volaser/volaser-cad/README.md

# volaser-cad
CAD files and assembly instructions to create your very own volaser

## Assembly
Assembly instructions are detailed step by step in the [wiki](https://github.com/volaser/volaser-cad/wiki)
