volaser/volaser-cad/images/capacitor.jpg

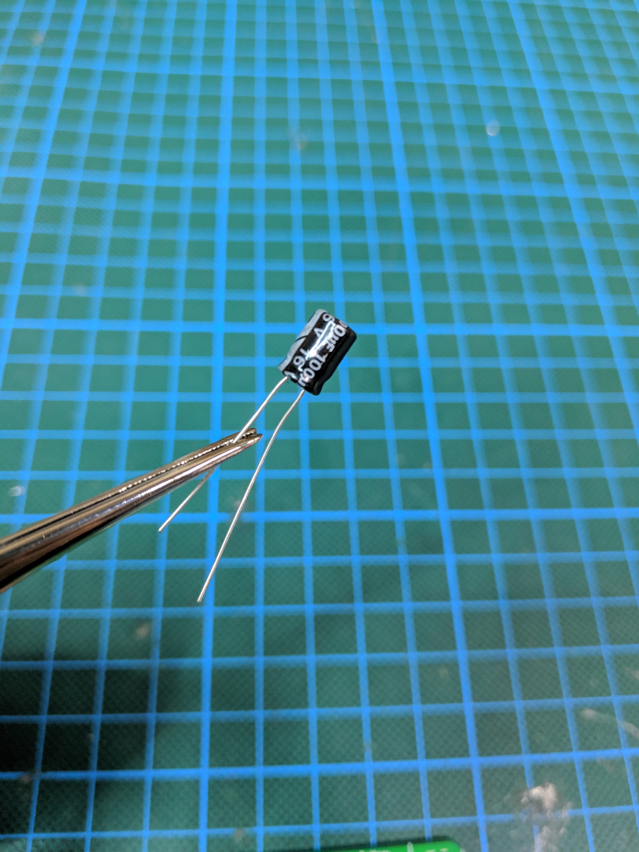
images/capacitor.jpg
