volaser/volaser-cad/images/volaser_motor_driver.jpg

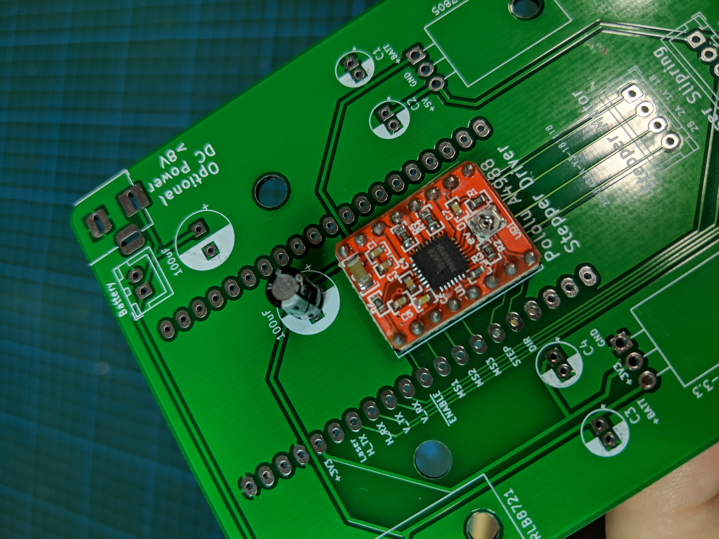
images/volaser_motor_driver.jpg
