volaser/volaser-cad/images/volaser_pcb.jpg

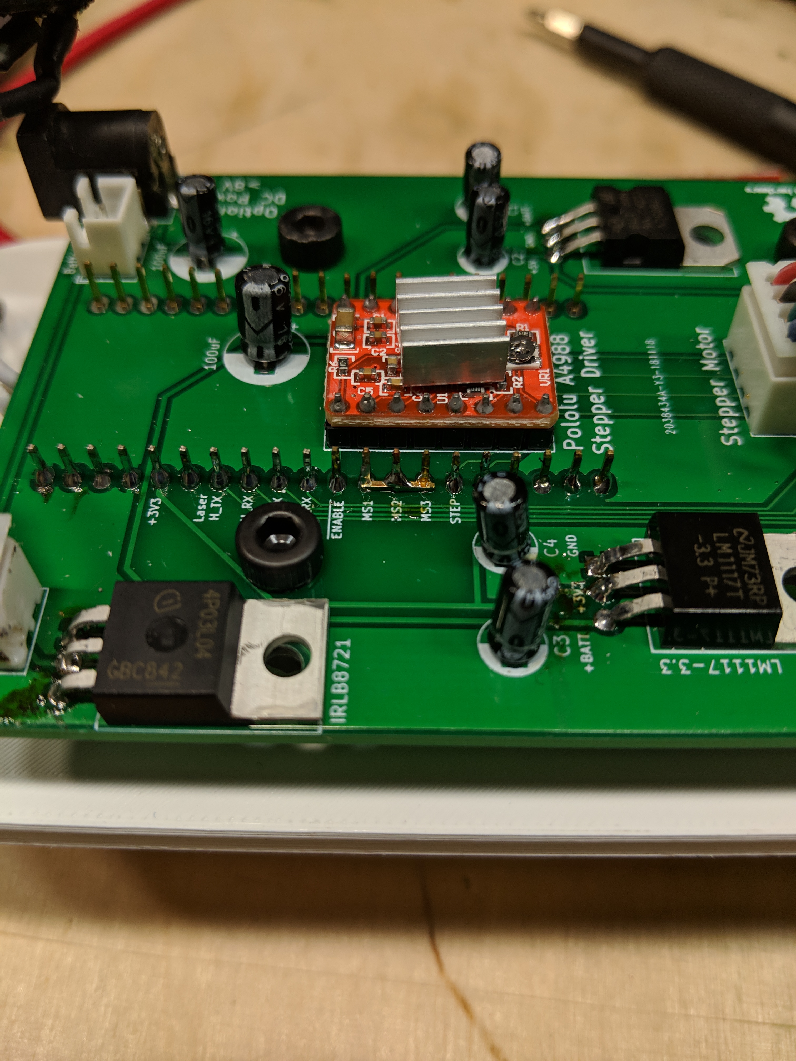
images/volaser_pcb.jpg
