volaser/volaser-cad/images/volaser_stepper.jpg

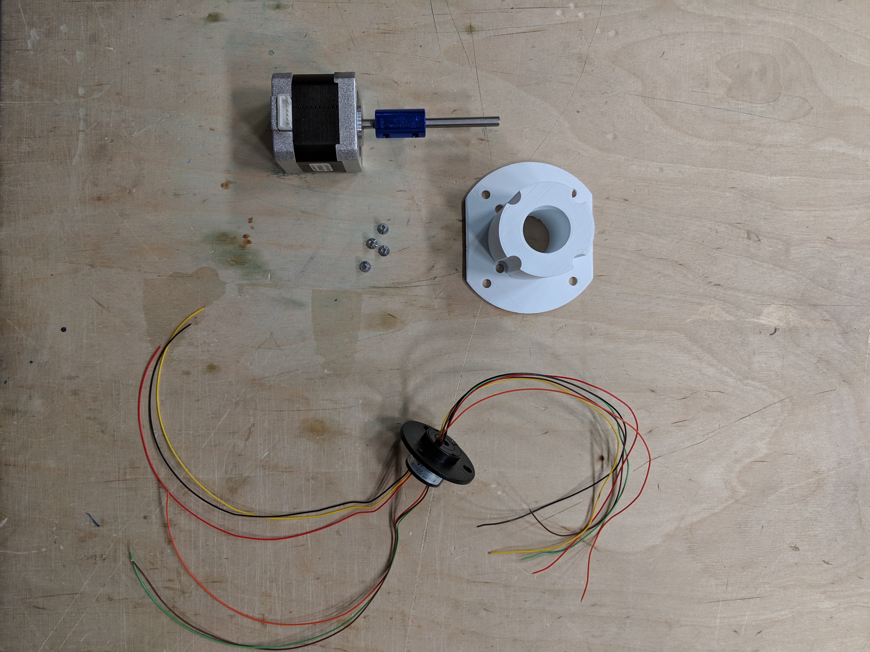
images/volaser_stepper.jpg
