volaser/volaser-cad/images/volaser_voltage_regulator.jpg

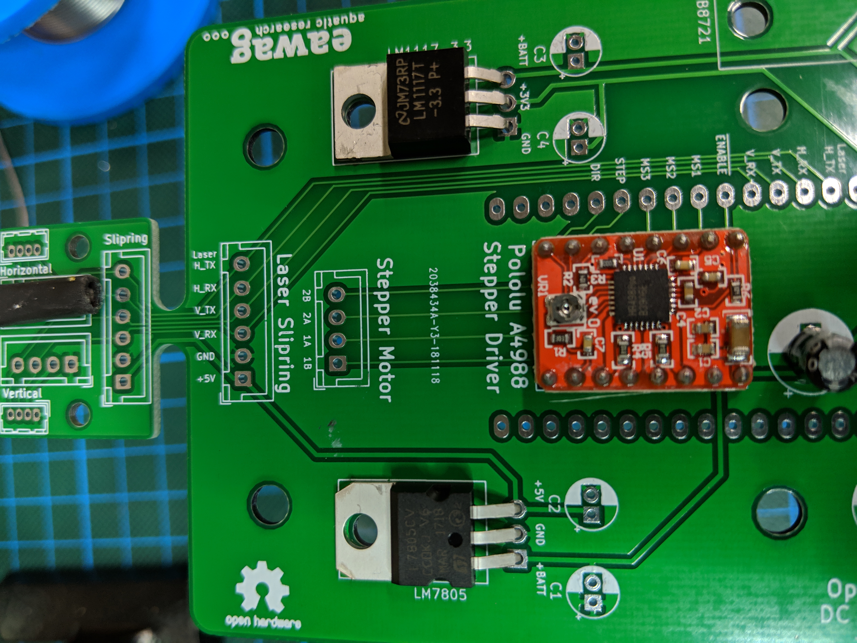
images/volaser_voltage_regulator.jpg
