volaser/volaser-cad/images/winch_capacitors.jpg

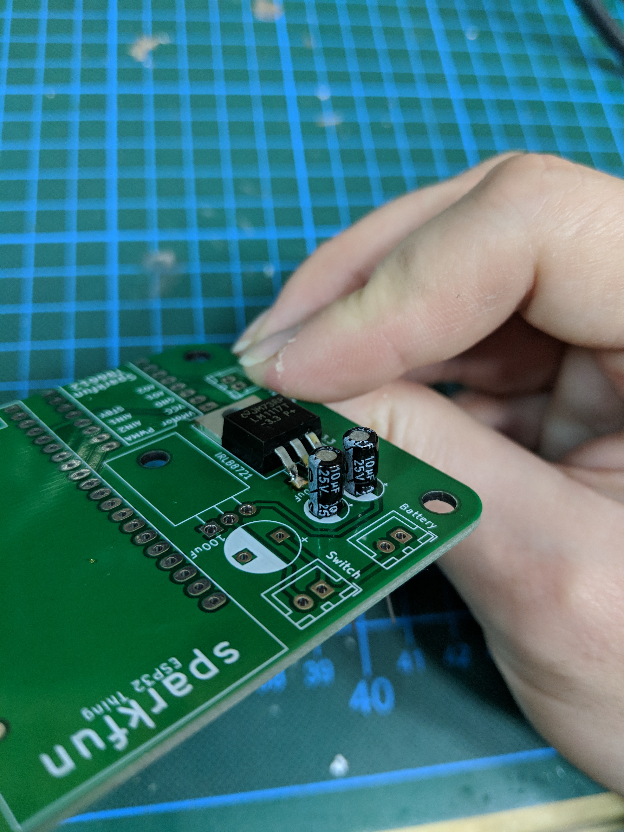
images/winch_capacitors.jpg
