volaser/volaser-cad/images/winch_connectors.jpg

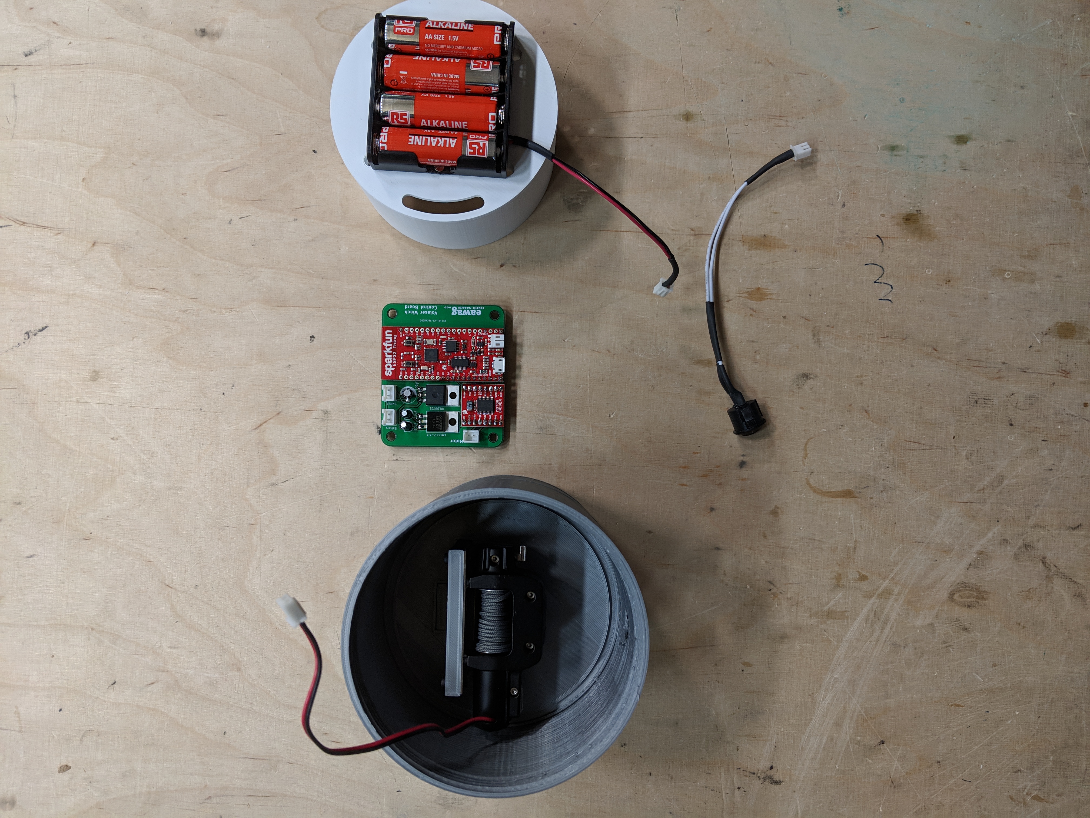
images/winch_connectors.jpg
