volaser/volaser-cad/images/winch_pcb_mounted.jpg

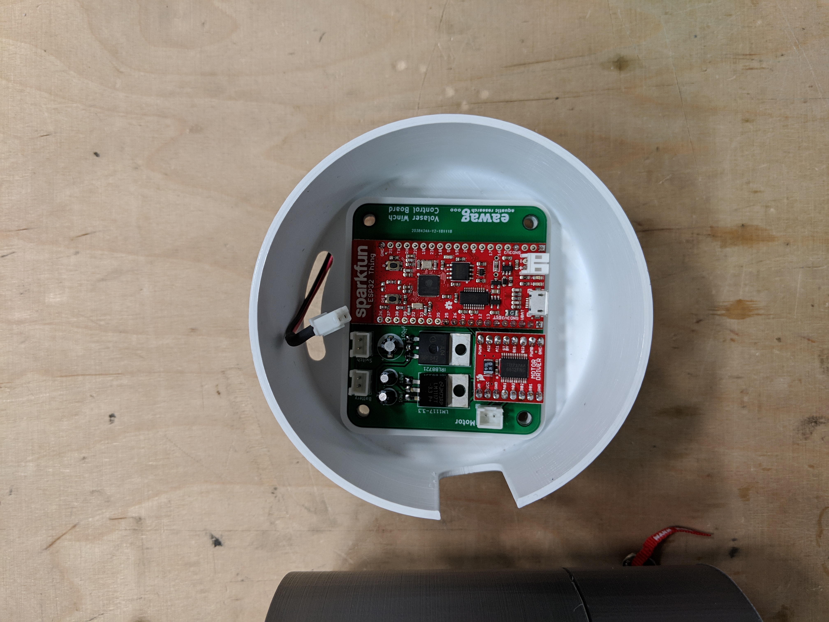
images/winch_pcb_mounted.jpg
