volaser/volaser-cad/winch-pcb/images/volaser_winch2.png

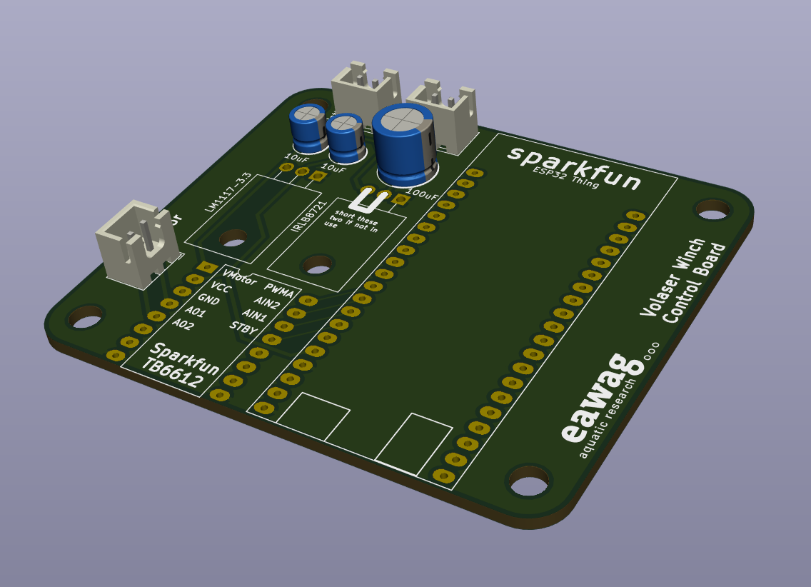
winch-pcb/images/volaser_winch2.png
