volaser/volaser-cad/volaser-parts/housing_cap.stl

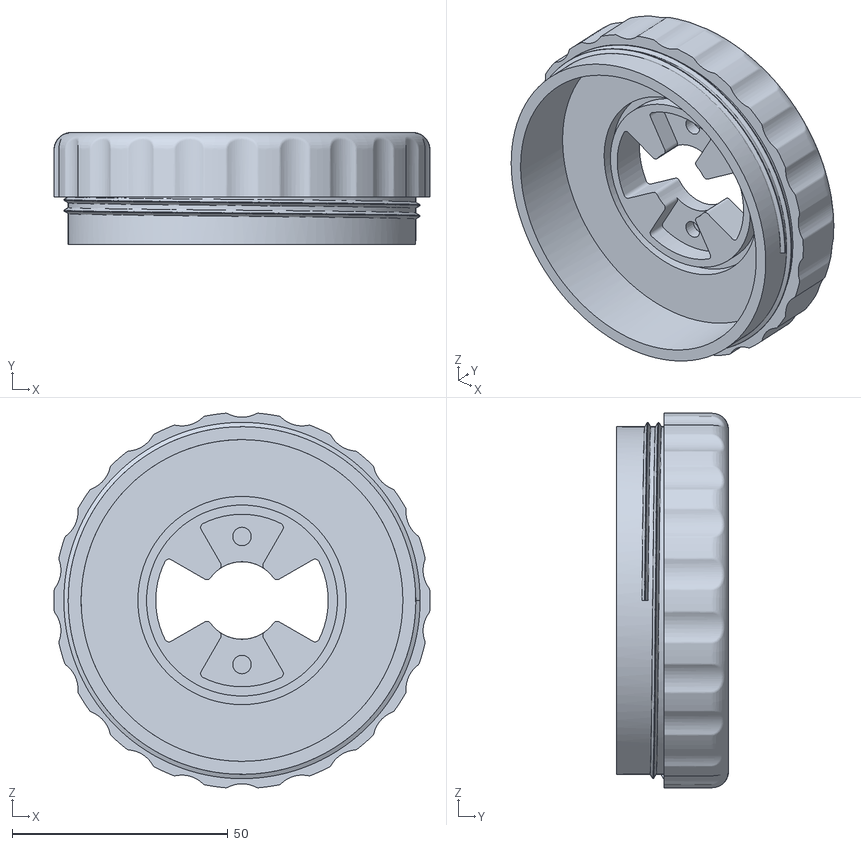
[picture p12: CAD file, 2019-01-12]
volaser-parts/housing_cap.stl
87.2 x 26.0 x 86.9
