volaser/volaser-cad/volaser-pcb/volaser.step

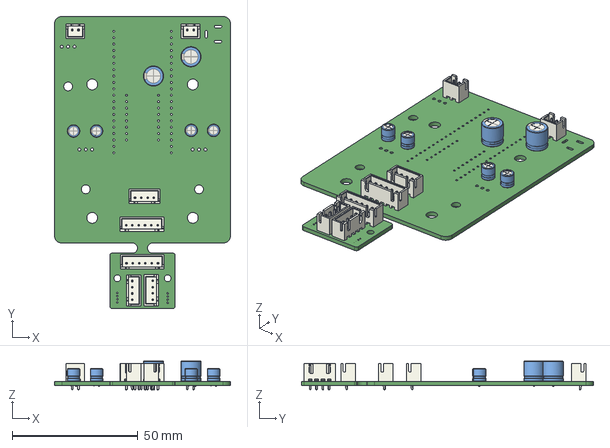
[picture p13: CAD file, 2019-01-12]
volaser-pcb/volaser.step
70.0 x 116.0 x 11.4 mm
