volaser/volaser-cad/winch-parts/winch_motor_mount.stl

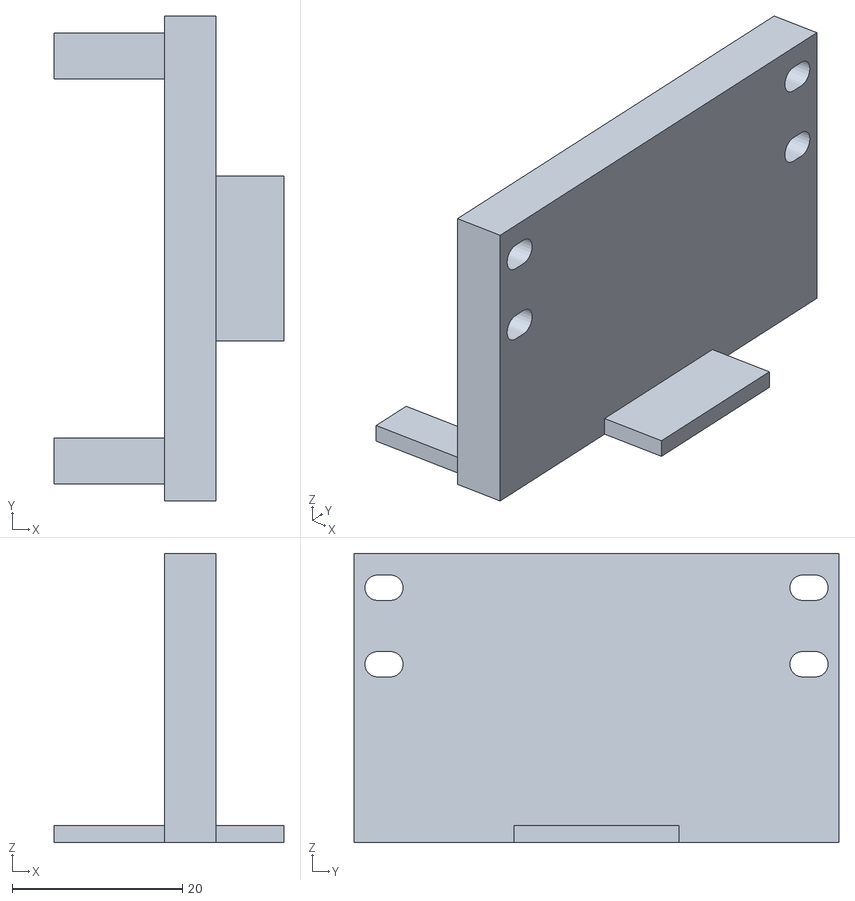
[picture p14: CAD file, 2019-01-12]
winch-parts/winch_motor_mount.stl
27.0 x 57.0 x 34.0
