volaser/volaser-cad/winch-pcb/winch.step

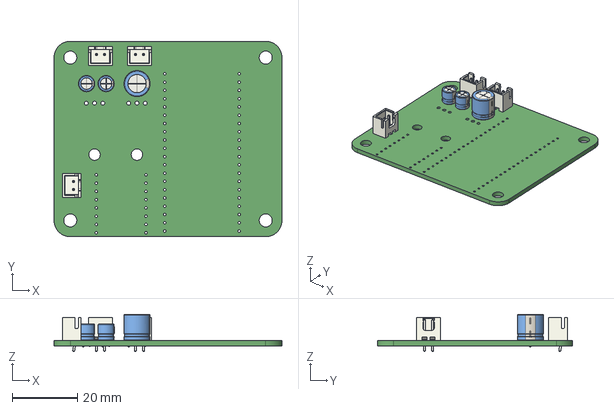
[picture p15: CAD file, 2019-01-12]
winch-pcb/winch.step
70.0 x 60.0 x 11.4 mm
