volaser/volaser-cad/volaser-parts/cap.stl

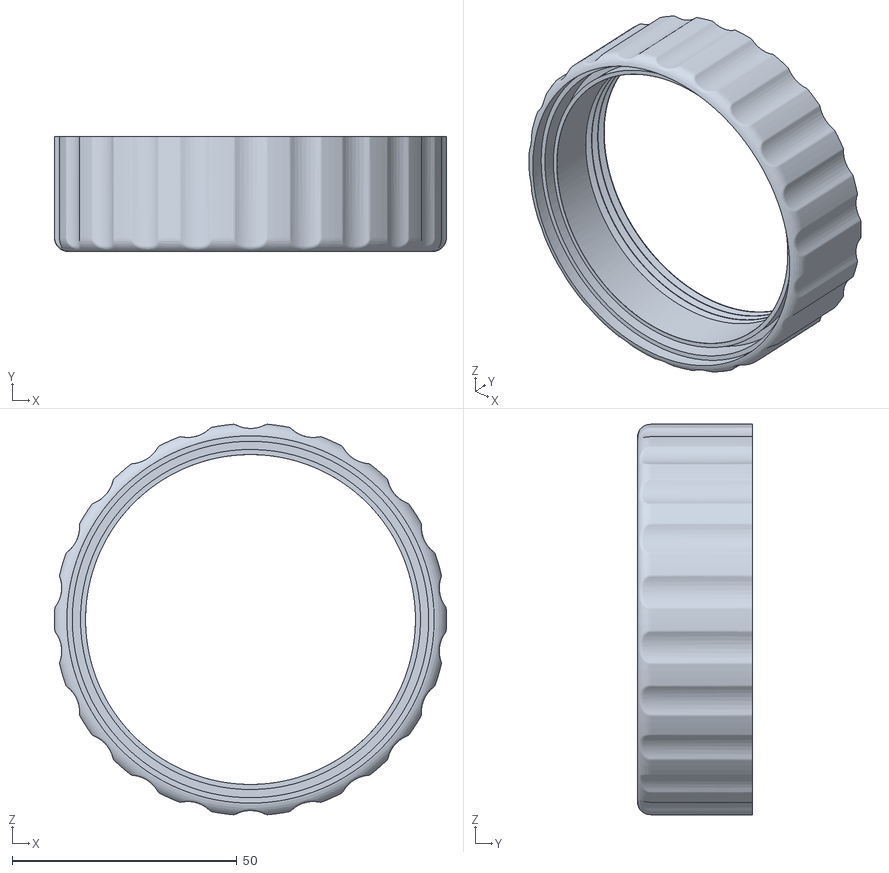
[picture p16: CAD file, 2019-01-12]
volaser-parts/cap.stl
87.2 x 25.5 x 86.9
