volaser/volaser-cad/winch-parts/winch_cap.stl

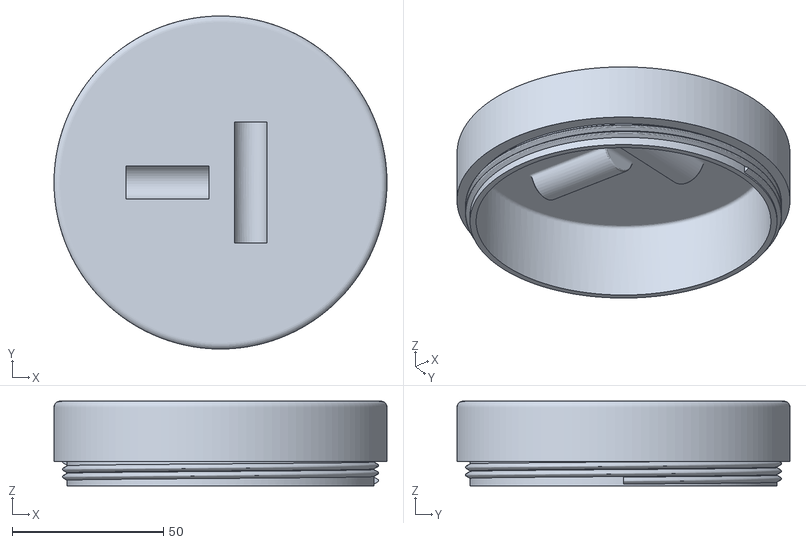
[picture p17: CAD file, 2019-01-12]
winch-parts/winch_cap.stl
110.0 x 110.0 x 28.0
