volaser/volaser-cad/volaser-parts/laser_holder.stl

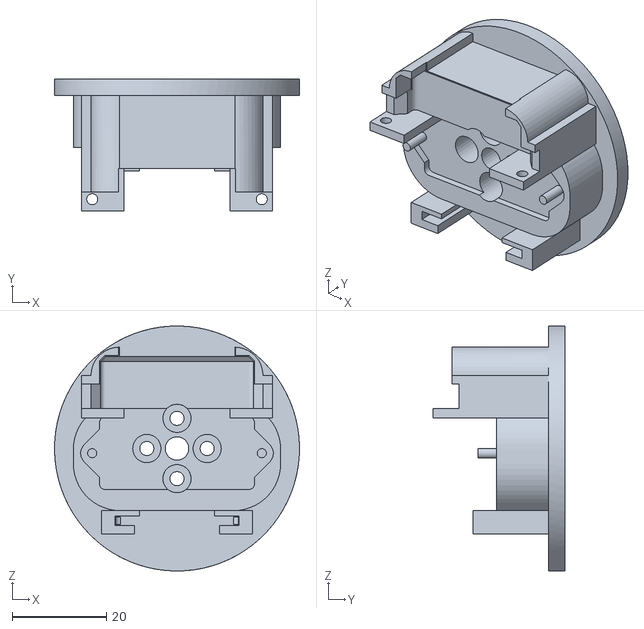
[picture p18: CAD file, 2019-01-12]
volaser-parts/laser_holder.stl
52.0 x 28.0 x 52.0
