volaser/volaser-cad/winch-parts/level_cover1.stl

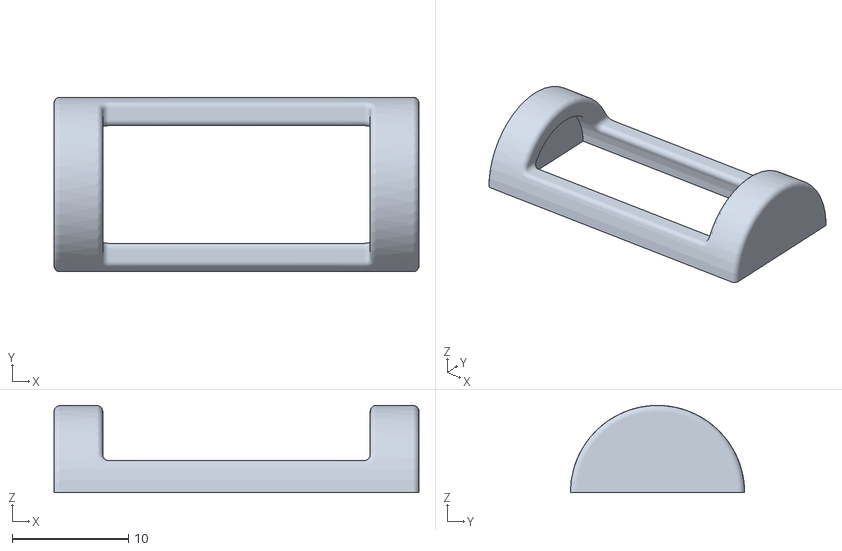
[picture p19: CAD file, 2019-01-12]
winch-parts/level_cover1.stl
31.4 x 15.0 x 7.50
