volaser/volaser-cad/volaser-parts/spine.stl

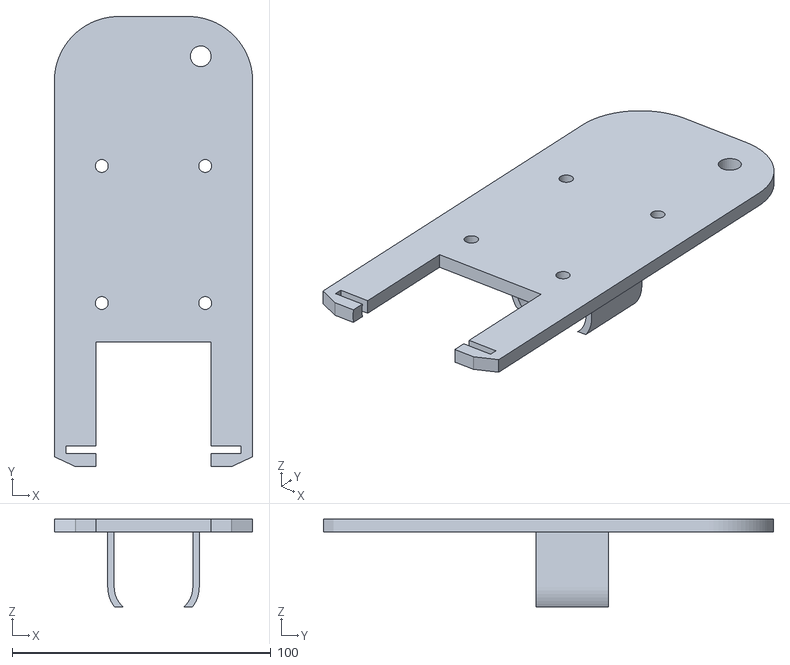
[picture p20: CAD file, 2019-01-12]
volaser-parts/spine.stl
76.7 x 174.0 x 34.0
