volaser/volaser-cad/winch-parts/winch_lower_housing.stl

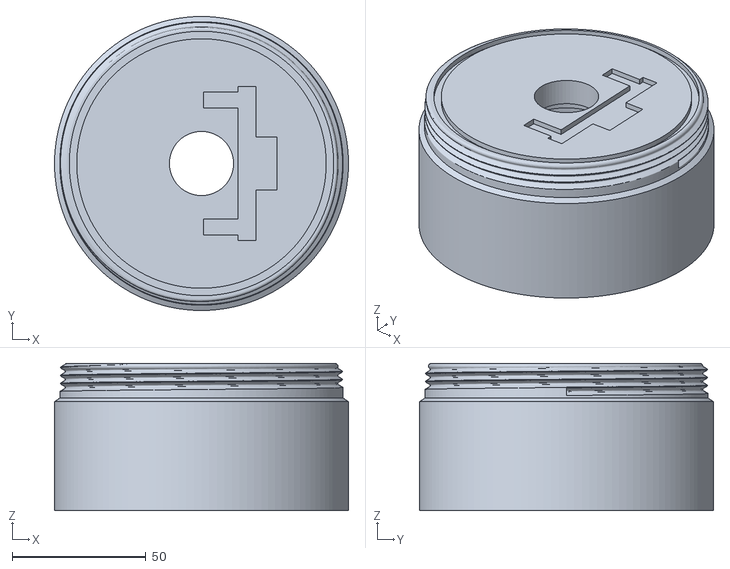
[picture p21: CAD file, 2019-01-12]
winch-parts/winch_lower_housing.stl
110.0 x 110.0 x 55.0
