volaser/volaser-cad/volaser-parts/winch_hook.stl

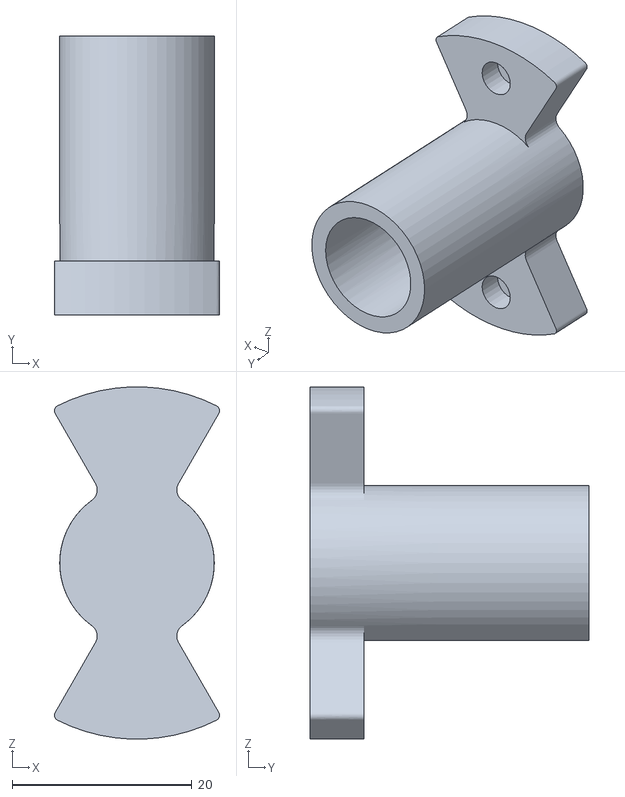
[picture p22: CAD file, 2019-01-12]
volaser-parts/winch_hook.stl
18.4 x 31.0 x 39.2
