volaser/volaser-cad/winch-parts/level_cover2.stl

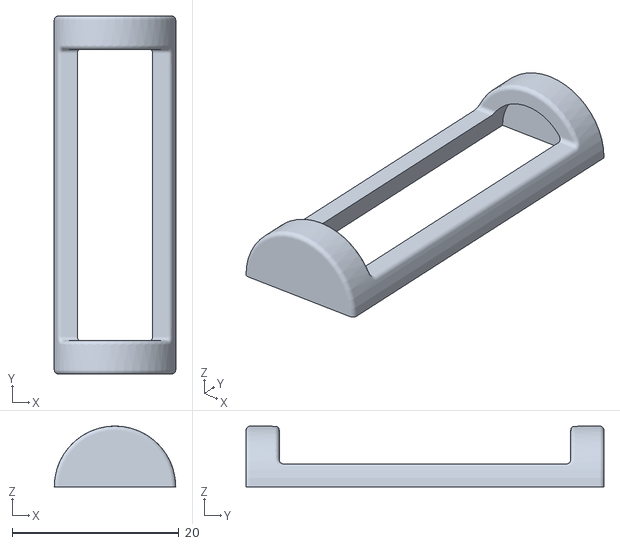
[picture p23: CAD file, 2019-01-12]
winch-parts/level_cover2.stl
14.6 x 43.0 x 7.30
