volaser/volaser-cad/volaser-parts/lower_housing.stl

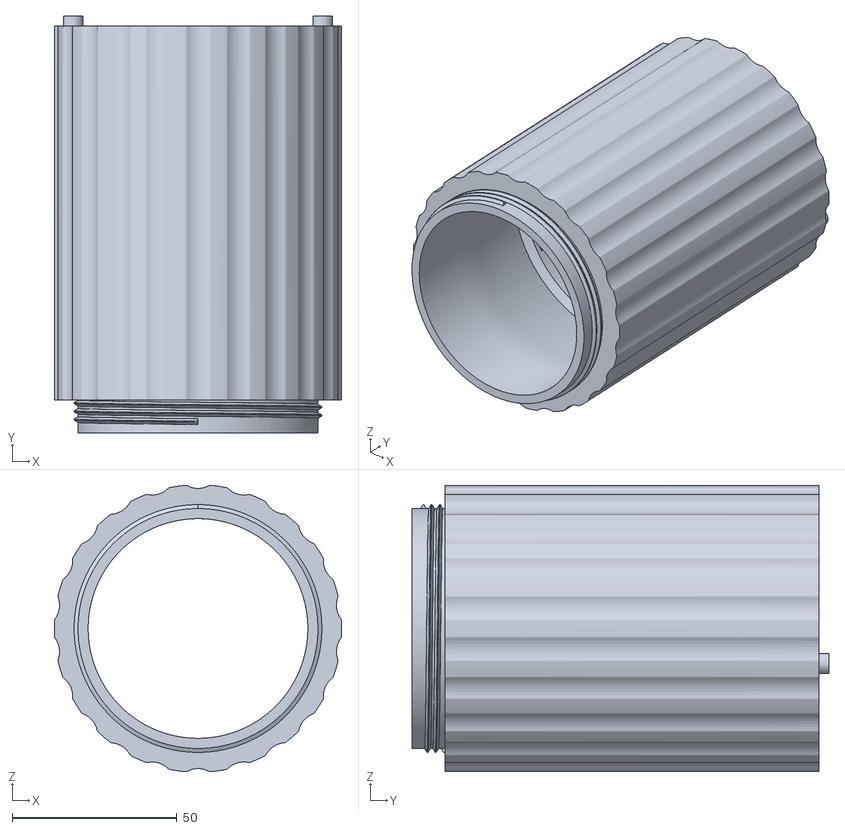
[picture p24: CAD file, 2019-01-12]
volaser-parts/lower_housing.stl
87.2 x 126.5 x 86.9
