volaser/volaser-cad/winch-parts/winch.step

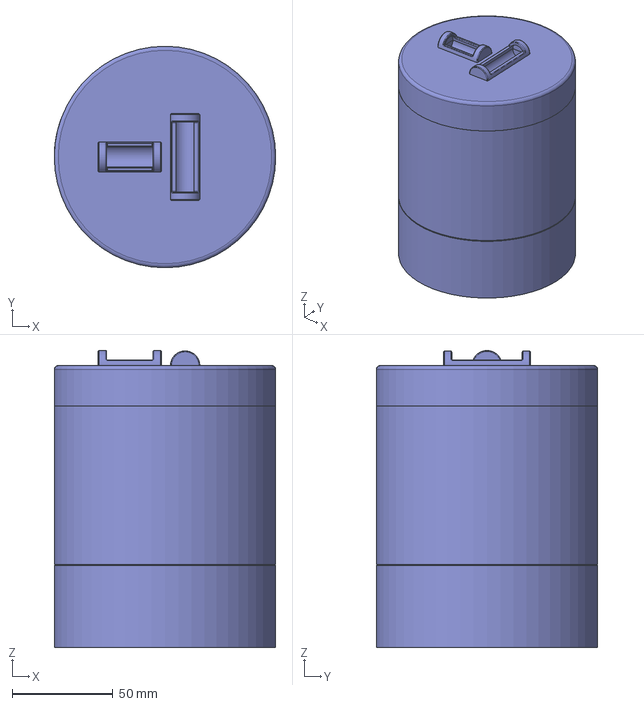
[picture p25: CAD file, 2019-01-12]
winch-parts/winch.step
110.0 x 110.0 x 147.5 mm
