volaser/volaser-cad/volaser-parts/upper_housing.stl

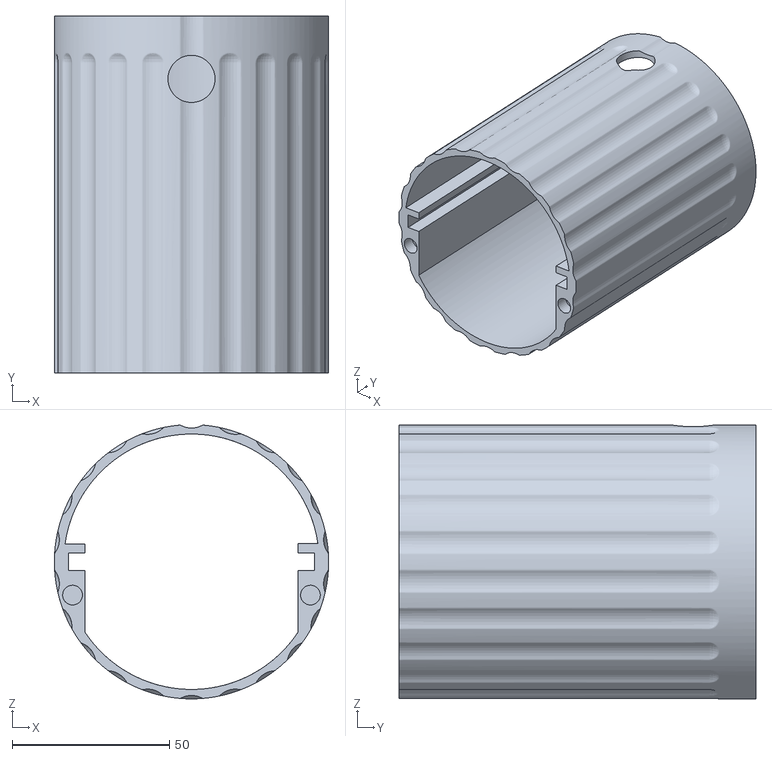
[picture p26: CAD file, 2019-01-12]
volaser-parts/upper_housing.stl
87.2 x 113.5 x 87.0
