volaser/volaser-cad/winch-parts/winch_pcb_mount.stl

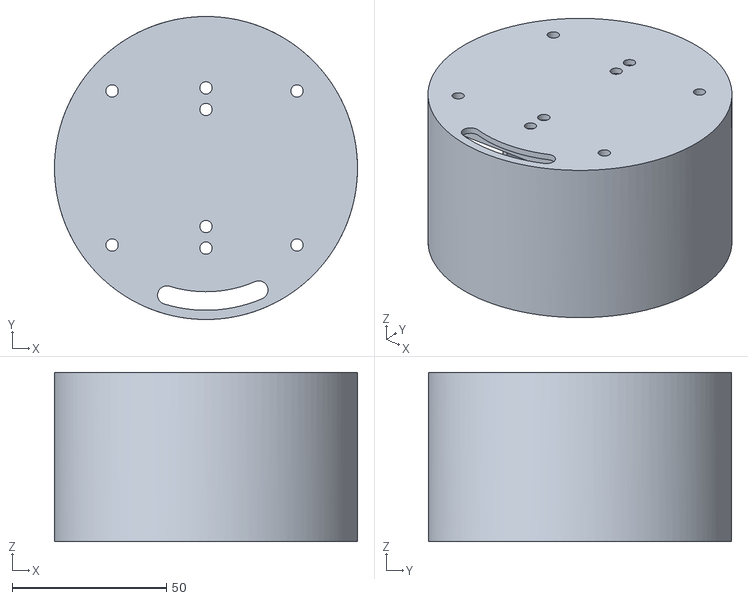
[picture p27: CAD file, 2019-01-12]
winch-parts/winch_pcb_mount.stl
98.3 x 98.3 x 55.0
