volaser/volaser-cad/volaser-parts/housing_cap_cover.stl

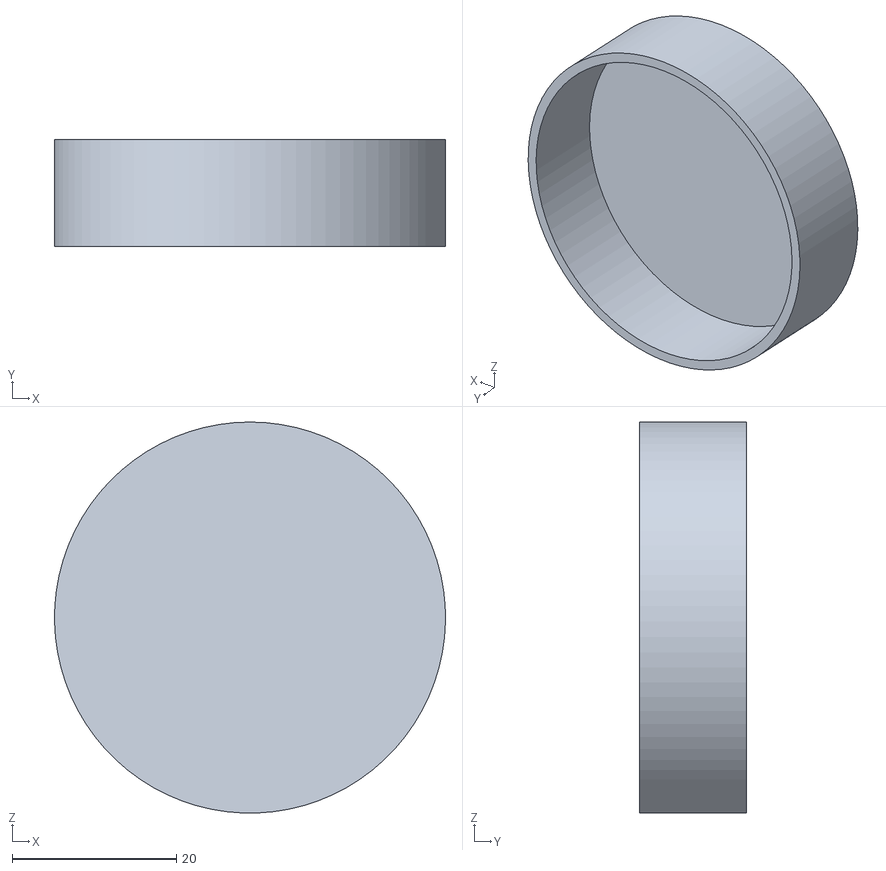
[picture p28: CAD file, 2019-01-12]
volaser-parts/housing_cap_cover.stl
47.7 x 13.0 x 47.7
