volaser/volaser-cad/volaser-parts/stepper_mount.stl

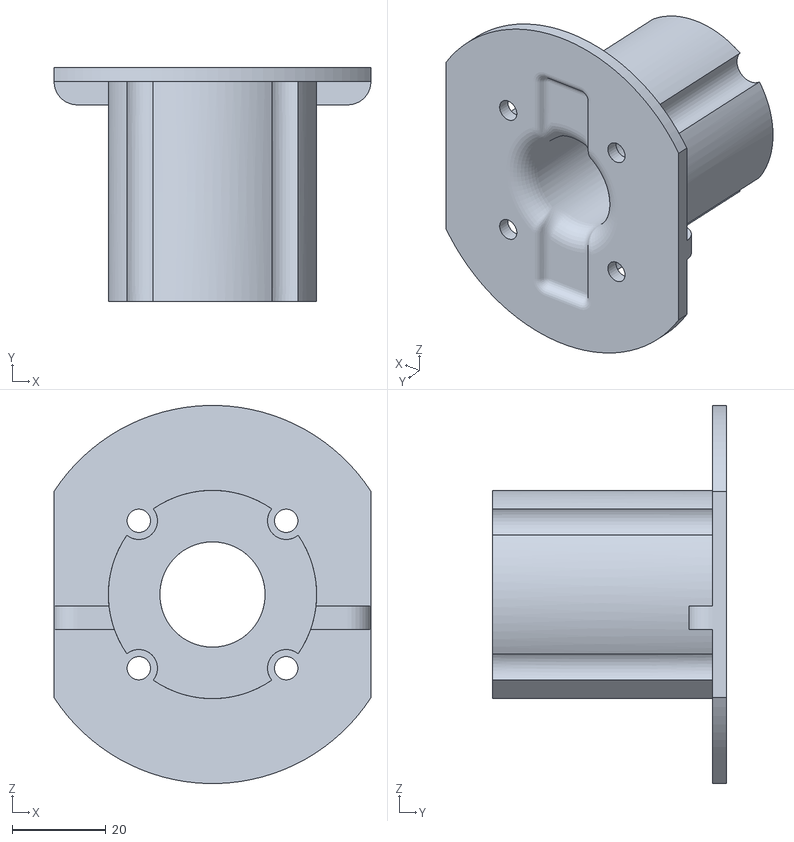
[picture p29: CAD file, 2019-01-12]
volaser-parts/stepper_mount.stl
67.7 x 50.0 x 80.8
