volaser/volaser-cad/volaser-pcb/images/volaser_schematic.pdf

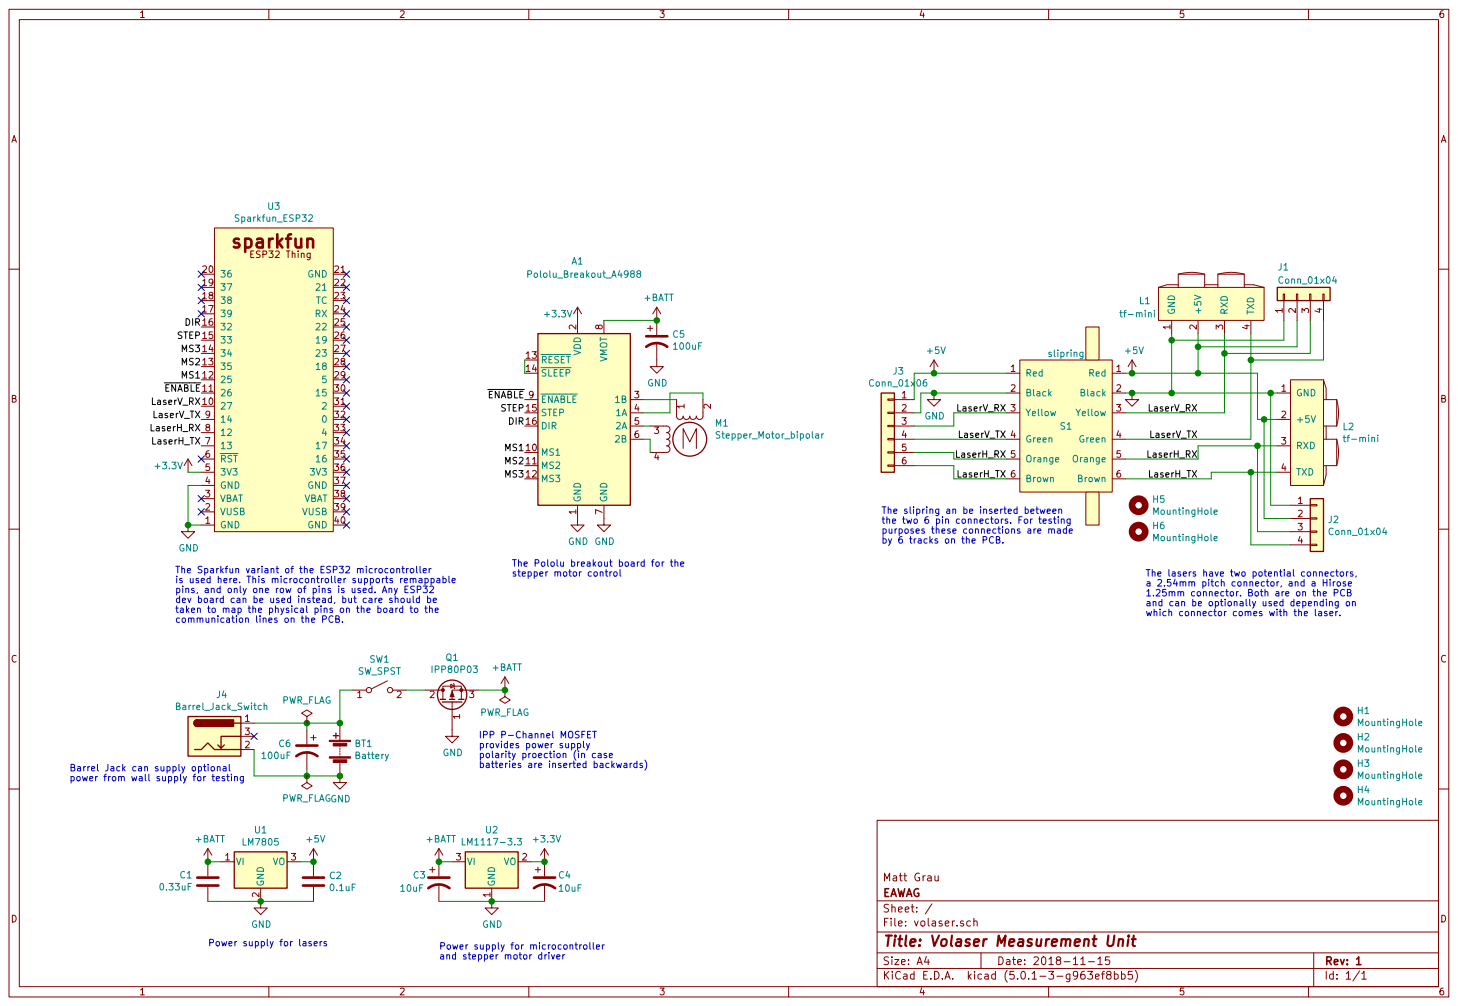
[picture p30: page 1]

1 MS1 10 MS2 11 MS3 12 RESET 13 SLEEP 14 STEP 15 DIR 16 VDD

The slipring an be inserted between
the two 6 pin connectors. For testing
purposes these connections are made
by 6 tracks on the PCB.

The Sparkfun variant of the ESP32 microcontroller
is used here. This microcontroller supports remappable
pins, and only one row of pins is used. Any ESP32
dev board can be used instead, but care should be
taken to map the physical pins on the board to the

The lasers have two potential connectors,
a 2.54mm pitch connector, and a Hirose
1.25mm connector. Both are on the PCB
and can be optionally used depending on which connector comes with the laser.

IPP P-Channel MOSFET
provides power supply
polarity proection (in case
batteries are inserted backwards)

Barrel Jack can supply optional
power from wall supply for testing

Id: 1/1 Title: Volaser Measurement Unit File: volaser.sch Sheet: / EAWAG Matt Grau GND

and stepper motor driver
