volaser/volaser-cad/winch-pcb/images/winch_schematic.pdf

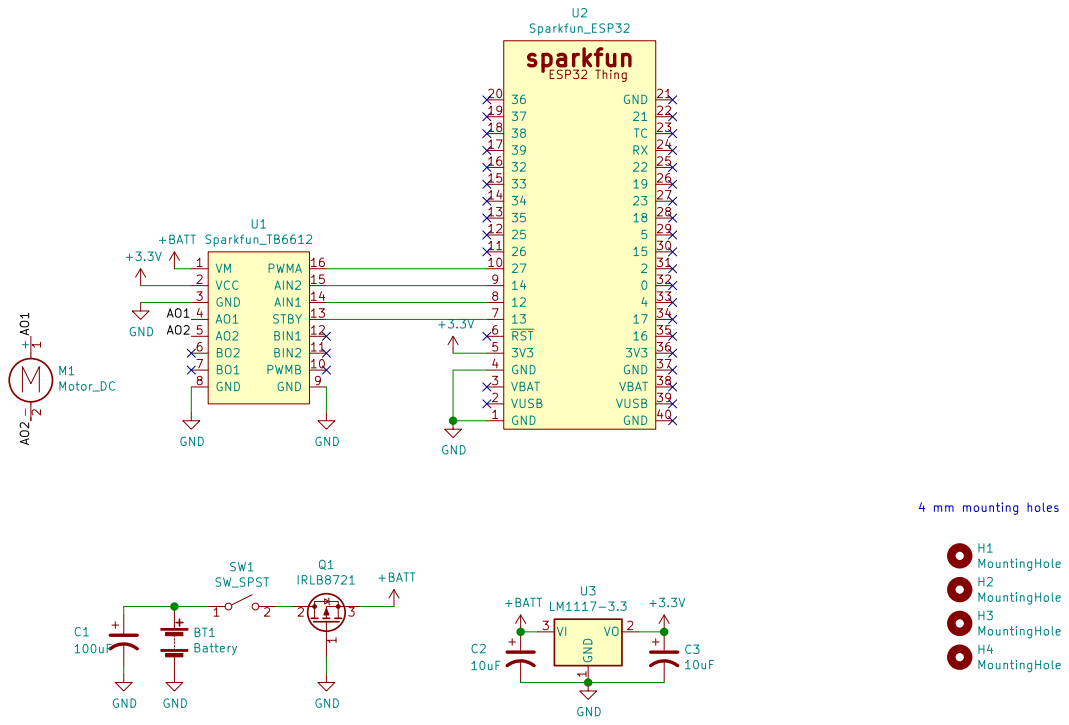
[picture p31: page 1]

File: winch.sch Sheet: / EAWAG Matt Grau

Id: 1/1 Title: Volaser Winch PCB
