volaser/volaser-cad/volaser-pcb/images/volaser_pcb.pdf

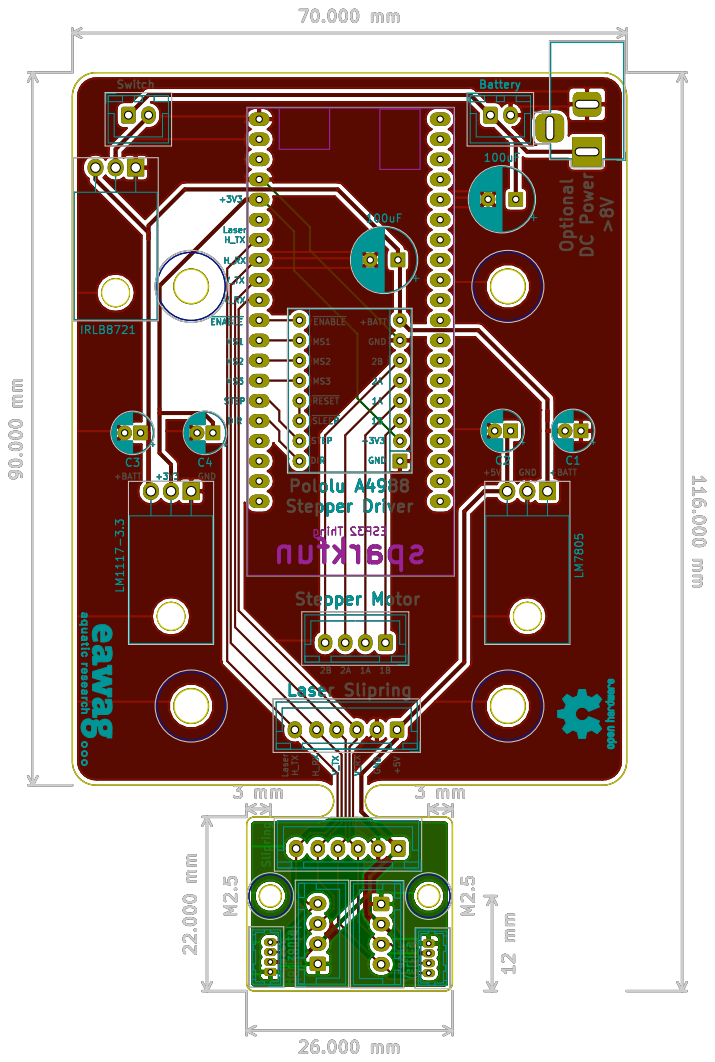
[picture p32: page 1]
