volaser/volaser-cad/winch-pcb/images/winch_pcb.pdf

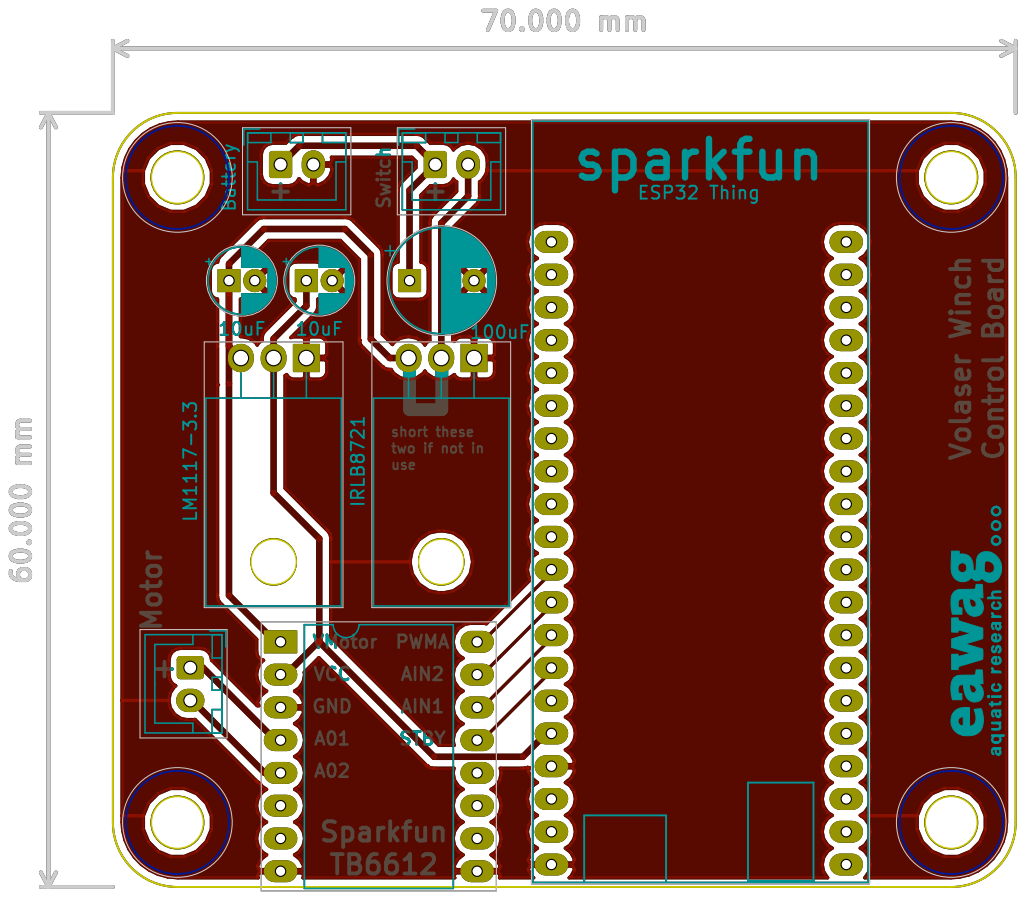
[picture p33: page 1]
