volaser/volaser-cad/volaser-pcb/volaser.kicad_pcb

## KiCad design volaser-pcb/volaser.kicad_pcb (2019-01-31)

Schematic: volaser.sch, Volaser Measurement Unit

Parts:
A1: Pololu_Breakout_A4988; Pololu_Breakout-16_15.2x20.3mm
BT1: Battery; JST_XH_B02B-XH-A_1x02_P2.54mm_Vertical
C1: 0.33uF; CP_Radial_D5.0mm_P2.00mm
C2: 0.1uF; CP_Radial_D5.0mm_P2.00mm
C3, C4: 10uF; CP_Radial_D5.0mm_P2.00mm
C5, C6: 100uF; CP_Radial_D8.0mm_P3.50mm
H1, H2, H3, H4: MountingHole; MountingHole_4.3mm_M4
H5, H6: MountingHole; MountingHole_2.7mm_M2.5
J1, J2: Conn_01x04; JST_XH_B04B-XH-A_1x04_P2.54mm_Vertical
J3: Conn_01x06; JST_XH_B06B-XH-A_1x06_P2.54mm_Vertical
J4: Barrel_Jack_Switch; BarrelJack_Horizontal
L1, L2: tf-mini; Hirose_DF13-04P-1.25DSA_1x04_P1.25mm_Vertical
M1: Stepper_Motor_bipolar; JST_XH_B04B-XH-A_1x04_P2.54mm_Vertical
Q1: IRLB8721; TO-220F-3_Horizontal_TabDown
S1: slipring; JST_XH_B06B-XH-A_1x06_P2.54mm_Vertical
SW1: SW_SPST; JST_XH_B02B-XH-A_1x02_P2.54mm_Vertical
U1: LM7805; TO-220F-3_Horizontal_TabDown
U2: LM1117-3.3; TO-220F-3_Horizontal_TabDown
U3: Sparkfun_ESP32

Connections:
+3V3: A1.2 (VDD), C4.1, U2.2 (VO), U3.5
+5V: C2.1, J1.2, J2.2, J3.1, L1.2, L2.2, S1.1, U1.3 (VO)
+BATT: A1.8 (VMOT), C1.2, C3.1, C5.1, Q1.3 (S), U1.1 (VI), U2.3 (VI)
/DIR: A1.16 (DIR), U3.16
/LaserH_RX: J2.3, J3.5, L2.3, S1.5, U3.8
/LaserH_TX: J2.4, J3.6, L2.4, S1.6, U3.7
/LaserV_RX: J1.3, J3.3, L1.3, S1.3, U3.10
/LaserV_TX: J1.4, J3.4, L1.4, S1.4, U3.9
/MS1: A1.10 (MS1), U3.12
/MS2: A1.11 (MS2), U3.13
/MS3: A1.12 (MS3), U3.14
/STEP: A1.15 (STEP), U3.15
/~ENABLE: A1.9 (~ENABLE), U3.11
GND: A1.1 (GND), A1.7 (GND), BT1.2 (-), C1.1, C2.2, C3.2, C4.2, C5.2, C6.2, J1.1, J2.1, J3.2, J4.2, L1.1, L2.1, Q1.1 (G), S1.2, U1.2 (GND), U2.1 (GND), U3.1, U3.4
unnamed: A1.3 (1B), M1.1
unnamed: A1.4 (1A), M1.2 (-)
unnamed: A1.5 (2A), M1.3
unnamed: A1.6 (2B), M1.4
unnamed: A1.13 (~RESET), A1.14 (~SLEEP)
unnamed: BT1.1 (+), C6.1, J4.1, SW1.1 (A)
unnamed: Q1.2 (D), SW1.2 (B)

Notes on the sheet:
The Sparkfun variant of the ESP32 microcontroller is used here. This microcontroller supports remappable pins, and only one row of pins is used. Any ESP32 dev board can be used instead, but care should be taken to map the physical pins on the board to the communication lines on the PCB.
The Pololu breakout board for the

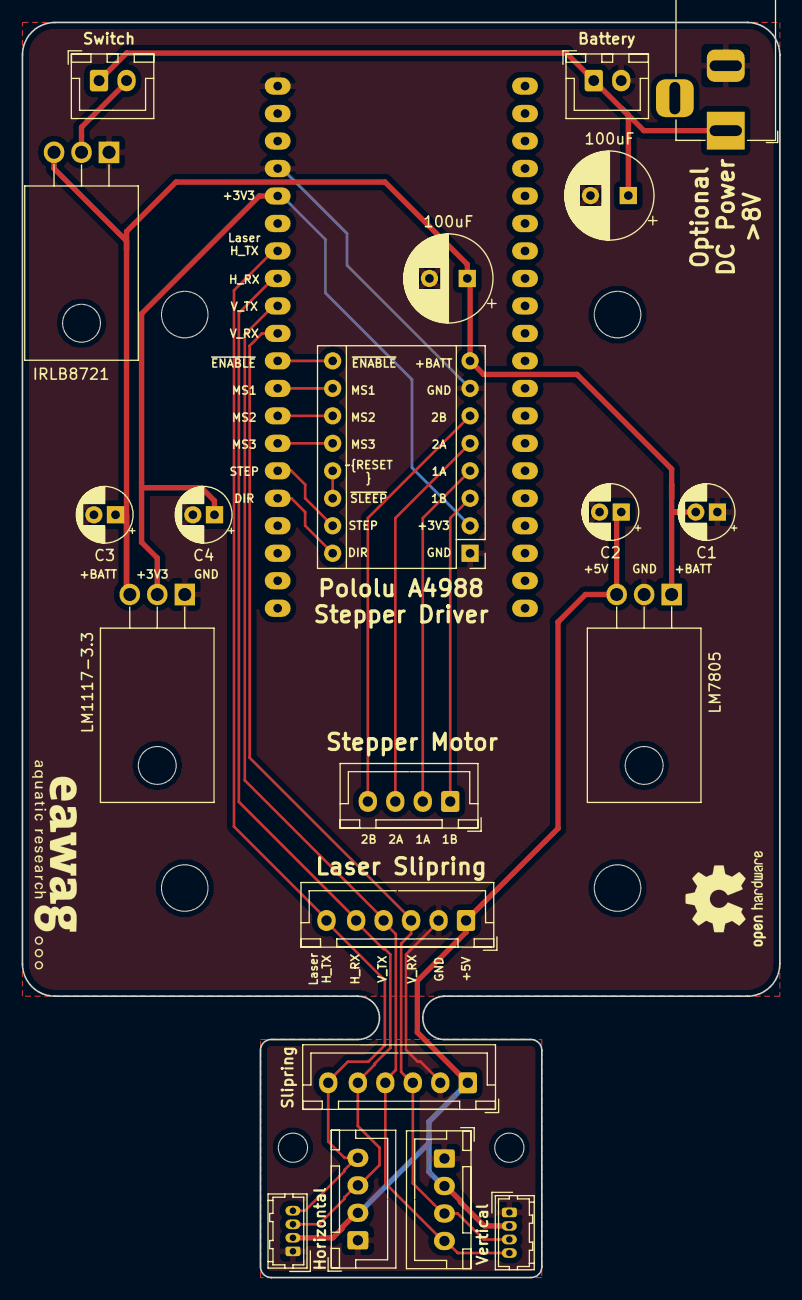
[picture p34: board volaser.kicad_pcb from above]

Board: 2 copper layers, 70.0 x 116.0 mm, 27 parts (1 on the bottom side), 21 nets.
