volaser/volaser-cad/winch-pcb/winch.kicad_pcb

## KiCad design winch-pcb/winch.kicad_pcb (2019-01-28)

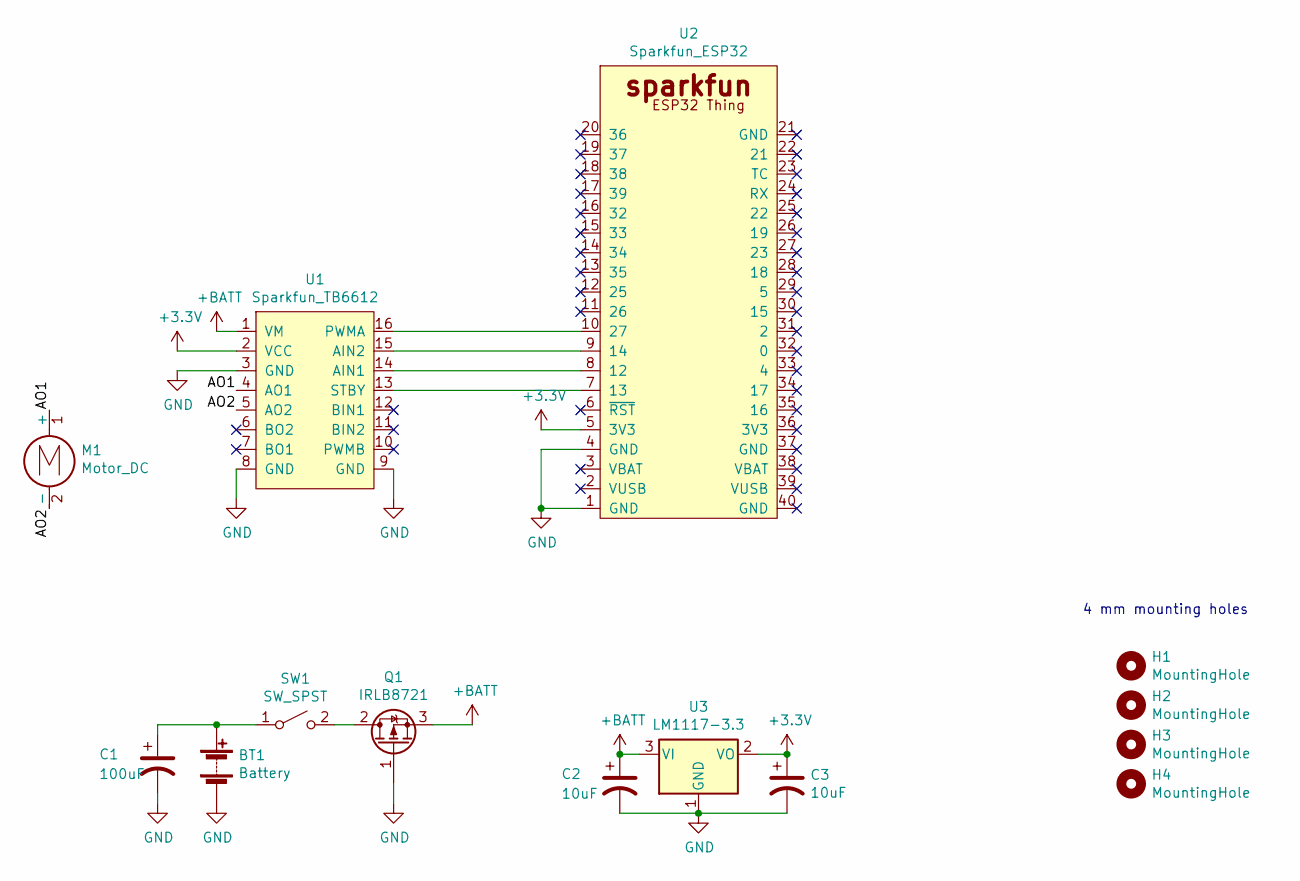
[picture p35: schematic winch.sch, Volaser Winch PCB]

Parts:
BT1: Battery; JST_XH_B02B-XH-A_1x02_P2.54mm_Vertical
C1: 100uF; CP_Radial_D8.0mm_P5.00mm
C2, C3: 10uF; CP_Radial_D5.0mm_P2.00mm
H1, H2, H3, H4: MountingHole; MountingHole_4mm
M1: Motor_DC; JST_XH_B02B-XH-A_1x02_P2.54mm_Vertical
Q1: IRLB8721; TO-220F-3_Horizontal_TabDown
SW1: SW_SPST; JST_XH_B02B-XH-A_1x02_P2.54mm_Vertical
U1: Sparkfun_TB6612; TB6612
U2: Sparkfun_ESP32
U3: LM1117-3.3; TO-220F-3_Horizontal_TabDown

Connections:
+3V3: C3.1, U1.2 (VCC), U2.5 (3V3), U3.2 (VO)
+BATT: C2.1, Q1.3 (S), U1.1 (VM), U3.3 (VI)
/AO1: M1.1 (+), U1.4 (AO1)
/AO2: M1.2 (-), U1.5 (AO2)
GND: BT1.2 (-), C1.2, C2.2, C3.2, Q1.1 (G), U1.3 (GND), U1.8 (GND), U1.9 (GND), U2.1 (GND), U2.4 (GND), U3.1 (GND)
unnamed: BT1.1 (+), C1.1, SW1.1 (A)
unnamed: Q1.2 (D), SW1.2 (B)
unnamed: U1.13 (STBY), U2.7 (13)
unnamed: U1.14 (AIN1), U2.8 (12)
unnamed: U1.15 (AIN2), U2.9 (14)
unnamed: U1.16 (PWMA), U2.10 (27)

Notes on the sheet:
4 mm mounting holes

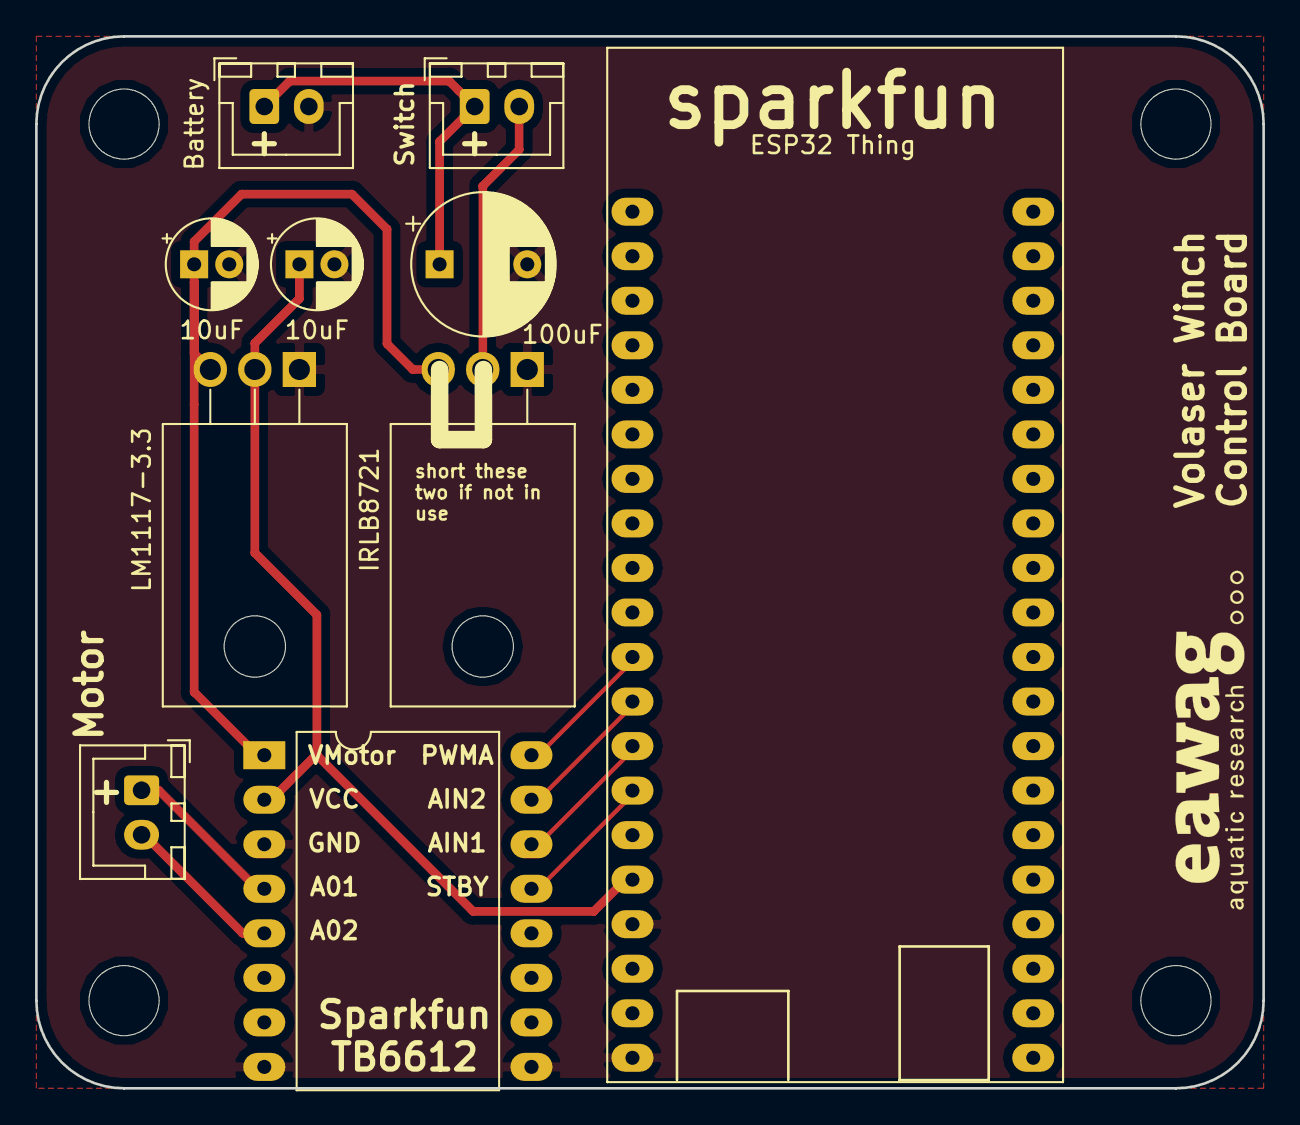
[picture p36: board winch.kicad_pcb from above]

Board: 2 copper layers, 70.0 x 60.0 mm, 14 parts (0 on the bottom side), 11 nets.
