volaser/volaser-cad/(commit log)

2019-01-12 added PCB and CAD files
    [cap.stl, housing_cap.stl, housing_cap_cover.stl, laser_holder.stl, level_cover1.stl, level_cover2.stl, lower_housing.stl, spine.stl]
2019-01-21 replaced lower housing with part from Clara on 01.12.18, should fit the tripod
2019-01-21 fixed bad previous commit, winch lower housing now in correct place, volaser lower housing restored
2019-01-28 added pictures for assembly
2019-01-28 created pdfs and pngs of schmatic and board
    [winch.kicad_pcb, winch.sch]
2019-01-31 add a finished picture of the winch PCB
2019-01-31 added a readme to volaser-pcb
    [volaser.kicad_pcb]
